Nitrokey/nitrokey-trng-usb-hardware/fabrication-data/trng-bom.xlsx

BOM Version: 1 | Nitrokey TRNG USB - Chaos | 19. Aug. 2022
RD | Value | Footprint | Quantity | Manufacturer | MPN | URL | Alternative
> C1, C2 | 220p 50V 5% C0G | Capacitor_SMD:C_0603_1608Metric | 2 | Murata | GRM1885C1H221JA01D | https://www.digikey.de/en/products/detail/GRM1885C1H221JA01D/490-1435-1-ND/587673?curr=usd
C3 | 22n C0G | Capacitor_SMD:C_0402_1005Metric | 1
> C4, C5 | 47p C0G | Capacitor_SMD:C_0402_1005Metric | 2
> C6, C7 | 4.7u 25V X7R | Capacitor_SMD:C_0603_1608Metric | 2
J1 | 480372200 | trng-parts:USB-A-PLUG | 1 | Molex | 480372200 | https://www.digikey.de/de/products/detail/molex/0480372200/2421361
> R1, R2 | 8.2K 1% | Resistor_SMD:R_0402_1005Metric | 2
> R3-R6, R9 | 10K 1% | Resistor_SMD:R_0402_1005Metric | 5
> R7, R8 | 27R 1% | Resistor_SMD:R_0402_1005Metric | 2
U1 | FT240XQ | Package_DFN_QFN:QFN-24-1EP_4x4mm_P0.5mm_EP2.6x2.6mm | 1 | FTDI | FT240XQ-T | https://www.digikey.de/en/products/detail/ftdi-future-technology-devices-international-ltd/FT240XQ-T/3749473
> U2, U3 | MC74VHC1G66DFT1G | Package_TO_SOT_SMD:SOT-353_SC-70-5 | 2 | onsemi | MC74VHC1G66DFT1G | https://de.farnell.com/webapp/wcs/stores/servlet/ProductDisplay?catalogId=15001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
U4 | TSV912IQ2T | Package_DFN_QFN:DFN-8-1EP_2x2mm_P0.5mm_EP1.05x1.75mm | 1 | ST | TSV912IQ2T | https://de.farnell.com/stmicroelectronics/tsv912iq2t/op-verst-rker-8mhz-4-5v-us-dfn/dp/2762662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 | TSV7722IQ2T
U5 | TS3022IYST | Package_SO:MSOP-8_3x3mm_P0.65mm | 1 | ST | TS3022IYST | https://www.digikey.de/en/products/detail/stmicroelectronics/TS3022IYST/8321879 | MAX942EUA+
