Nitrokey/nitrokey-trng-usb-hardware/trng.pdf

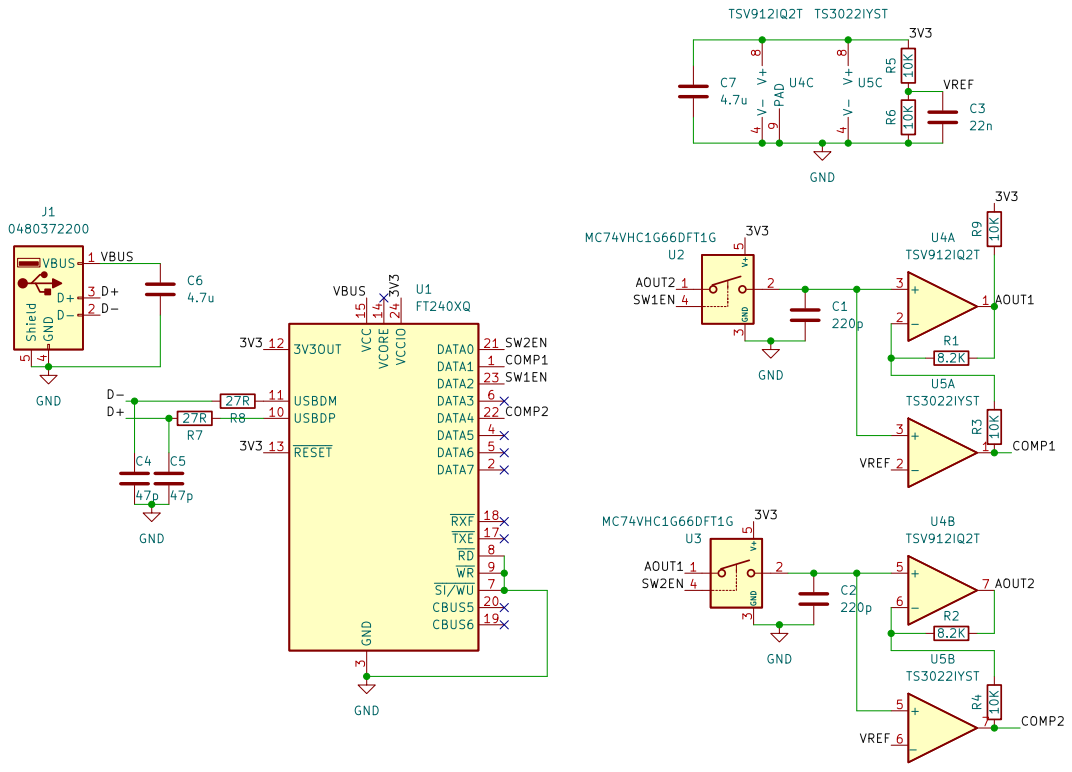
[picture p1: page 1]

3 DATA5 4 DATA6 5 DATA3 6 ~{SI/WU} 7 ~{RD} 8 ~{WR} 9 U1FT240XQ
