Nitrokey/nitrokey-trng-usb-hardware/trng.kicad_pcb

## KiCad design trng.kicad_pcb (2022-06-23)

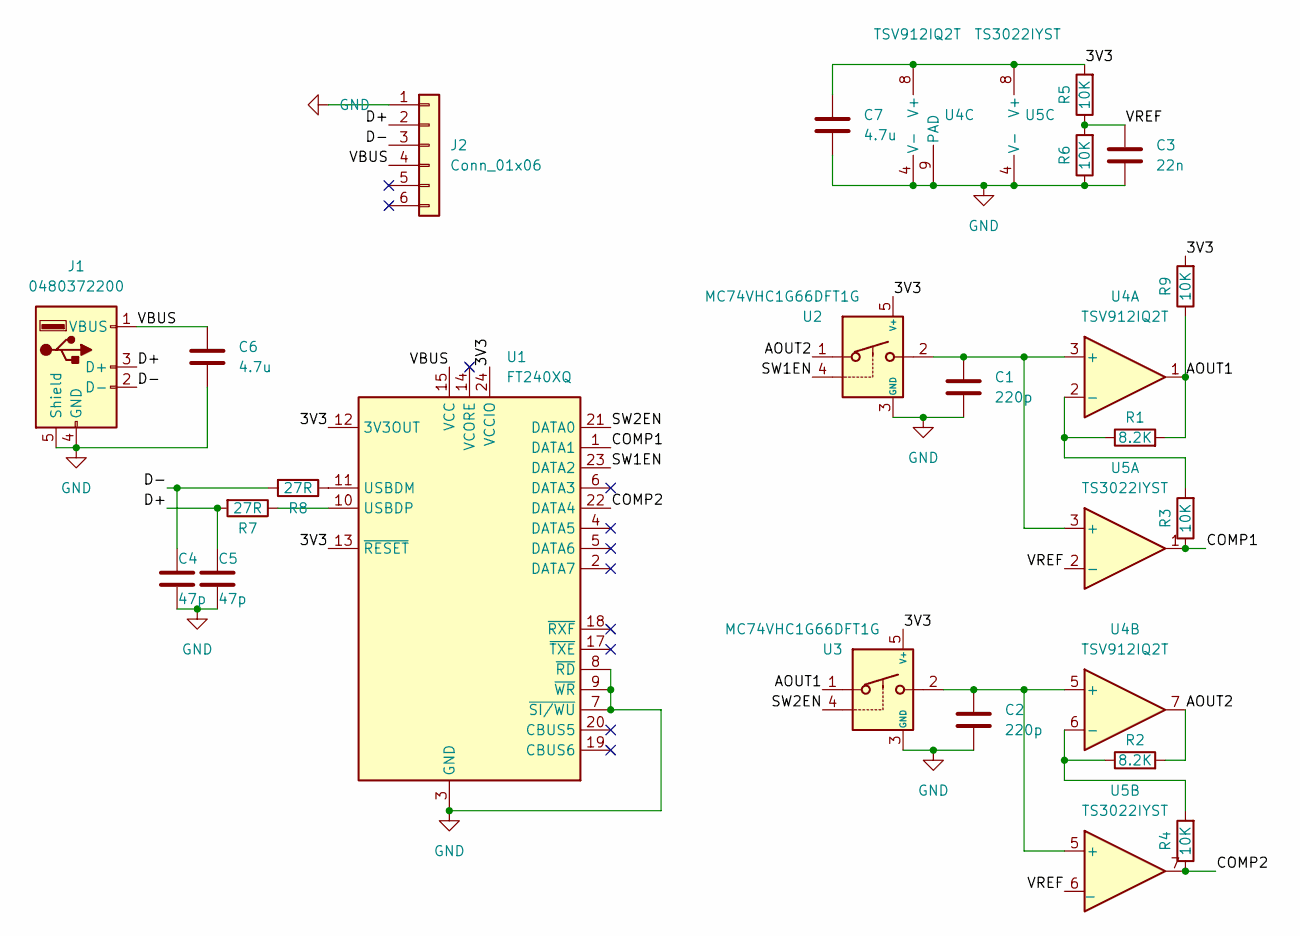
[picture p2: schematic trng.kicad_sch]

Parts:
C1, C2: 220p; C_0603_1608Metric
C3: 22n; C_0402_1005Metric
C4, C5: 47p; C_0402_1005Metric
C6, C7: 4.7u; C_0603_1608Metric
J1: 0480372200; USB-A-PLUG
J2: Conn_01x06; nitro_programming_header
R1, R2: 8.2K; R_0402_1005Metric
R3, R4, R5, R6, R9: 10K; R_0402_1005Metric
R7, R8: 27R; R_0402_1005Metric
U1: FT240XQ; QFN-24-1EP_4x4mm_P0.5mm_EP2.6x2.6mm
U2, U3: MC74VHC1G66DFT1G; SOT-353_SC-70-5
U4: TSV912IQ2T; DFN-8-1EP_2x2mm_P0.5mm_EP1.05x1.75mm
U5: TS3022IYST

Connections:
/3V3: C7.1, R5.2, R9.2, U1.12 (3V3OUT), U1.13 (~RESET), U1.24 (VCCIO), U2.5 (V+), U3.5 (V+), U4.8 (V+), U5.8 (V+)
/AOUT1: R1.2, R9.1, U3.1, U4.1
/AOUT2: R2.2, U2.1, U4.7
/COMP1: R3.1, U1.1 (DATA1), U5.1
/COMP2: R4.1, U1.22 (DATA4), U5.7
/D+: C5.1, J1.3 (D+), J2.2, R7.2
/D-: C4.1, J1.2 (D-), J2.3, R8.2
/SW1EN: U1.23 (DATA2), U2.4
/SW2EN: U1.21 (DATA0), U3.4
/VBUS: C6.1, J1.1 (VBUS), J2.4, U1.15 (VCC)
/VREF: C3.1, R5.1, R6.2, U5.2 (-), U5.6 (_)
GND: C1.2, C2.2, C3.2, C4.2, C5.2, C6.2, C7.2, J1.4 (GND), J1.5 (Shield), J2.1, R6.1, U1.3 (GND), U1.7 (~SI/WU), U1.8 (~RD), U1.9 (~WR), U1.16 (GND), U1.25 (GND), U2.3 (GND), U3.3 (GND), U4.4 (V-), U4.9 (PAD), U5.4 (V-)
unnamed: C1.1, U2.2, U4.3 (+), U5.3 (+)
unnamed: C2.1, U3.2, U4.5 (+), U5.5 (+)
unnamed: R1.1, R3.2, U4.2 (-)
unnamed: R2.1, R4.2, U4.6 (-)
unnamed: R7.1, U1.10 (USBDP)
unnamed: R8.1, U1.11 (USBDM)

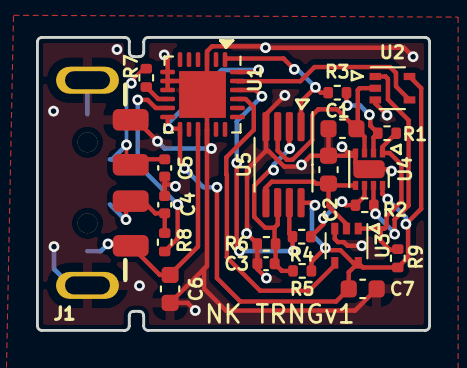
[picture p3: board trng.kicad_pcb from above]

Board: 2 copper layers, 21.8 x 16.3 mm, 23 parts (1 on the bottom side), 18 nets.
