Nitrokey/nitrokey-trng-usb-hardware/(commit log)

2022-04-08 Update schematic pdf, add BOM
    [trng-bom.xlsx, trng.kicad_pcb, trng.kicad_sch]
2022-04-12 add panelized gerbers and production data
    [out-B_Cu.gbl, out-B_Mask.gbs, out-B_Paste.gbp, out-B_Silkscreen.gbo, out-Edge_Cuts.gm1, out-F_Mask.gts, out-F_Paste.gtp, out-F_Silkscreen.gto]
2022-06-23 Add test header and recreate production data
    [out-B_Mask.gbs, out-B_Paste.gbp, out-B_Silkscreen.gbo, out-Edge_Cuts.gm1, out-F_Mask.gts, out-F_Paste.gtp, out-F_Silkscreen.gto, out-NPTH-drl_map.gbr]
2022-08-19 BOM: Alternatives TSV7722IQ2T, MAX942EUA+ added
    [trng-bom.xlsx]
